mariaDallOrto/nimbus-telemetry/(list of files, drawings)

Other design files:
pcb/kmetria.PcbDoc
pcb/kmetria.PcbLib
pcb/kmetria.PrjPcb
pcb/kmetria.SchDoc
pcb/kmetria.SchLib
