mariaDallOrto/nimbus-telemetry/public/examples/test_paje.csv

Timestamp | PacketID | RSSI_dBm | Corrente_A | Comando_Pct | TensaoTotal_V | Celulas_N | C1 | C2 | C3 | C4 | C5 | C6 | Corrente_Med_A | Corrente_Min_A | LoopMs | PwmIdleMs
2026-06-01T22_53_46 | 27346 | -43 | 1.92 | 0 | 16.52 | 4 | 4.073 | 4.182 | 4.136 | 4.125 | 0.000 | 0.000 | -0.18 | -1.35 | 19 | 14
2026-06-01T22_53_46 | 27347 | -43 | 2.17 | 0 | 16.52 | 4 | 4.073 | 4.181 | 4.136 | 4.124 | 0.000 | 0.001 | -0.19 | -1.35 | 19 | 4
2026-06-01T22_53_46 | 27348 | -43 | 2.04 | 0 | 16.52 | 4 | 4.073 | 4.181 | 4.137 | 4.125 | 0.000 | 0.000 | -0.19 | -1.22 | 19 | 14
2026-06-01T22_53_46 | 27349 | -42 | 1.29 | 0 | 16.52 | 4 | 4.073 | 4.182 | 4.136 | 4.124 | 0.000 | 0.000 | -0.26 | -2.48 | 19 | 3
2026-06-01T22_53_46 | 27350 | -42 | 1.04 | 0 | 16.51 | 4 | 4.073 | 4.181 | 4.136 | 4.124 | 0.000 | 0.000 | -0.22 | -1.35 | 19 | 13
2026-06-01T22_53_46 | 27351 | -42 | 0.66 | 0 | 16.52 | 4 | 4.073 | 4.181 | 4.137 | 4.124 | 0.000 | 0.000 | -0.23 | -1.60 | 19 | 3
2026-06-01T22_53_46 | 27352 | -42 | 0.91 | 0 | 16.52 | 4 | 4.073 | 4.182 | 4.136 | 4.124 | 0.000 | 0.000 | -0.17 | -1.22 | 19 | 13
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
