mariaDallOrto/nimbus-telemetry/(commit log)

2025-10-28 teste dos sensores
2025-10-31 Update README with ESP32 pinout details
    Added pinout information for the ESP32 module.
2025-12-11 Add ESP32 telemetry dashboard HTML file
2025-12-11 Add current divider note for current sensor
    Added information about using a current divider for the current sensor.
2025-12-18 Add HSTS016L-A current sensor and battery monitor code
    This file implements the reading of the HSTS016L-A current sensor with an ESP32, including battery monitoring using ADS1115 and PWM signal processing from the R84 receiver.
2025-12-18 Add HSTS016L-A sensor reading and logging
    Implement sensor reading and data logging for HSTS016L-A current sensor with ESP32, including battery monitoring and SD card storage.
2025-12-19 Add ESP32 telemetry code for sensor monitoring
2025-12-29 Change chart data from voltage to current
    Updated the chart to plot current instead of voltage and adjusted related configurations.
2025-12-29 Revise README for ESP32 telemetry project
    Updated README to provide detailed project information, features, hardware requirements, connection diagrams, installation instructions, and usage guidelines for the ESP32 RC telemetry and data logger system.
2025-12-29 pcb files
    [kmetria.PcbDoc, kmetria.PcbLib, kmetria.PrjPcb, kmetria.SchDoc, kmetria.SchLib]
2026-06-02 chore(web): remove legacy single-file dashboard prototype
2026-06-02 fix(firmware): auto-remount SD on failure and lower SPI clock to 10MHz
    [esp-wifi.ino]
2026-06-02 feat(telemetry): add gearbox reduction to RPM and share motor params
2026-06-02 fix(charts): keep the legend clear of the zoom and fullscreen buttons
2026-06-02 feat(analysis): add selectable example CSV logs with descriptions
    [pico.csv, pico_balta_luta.csv, pico_balta_luta2.csv, test_paje.csv]
2026-06-02 chore(pcb): move kmetria board files into pcb/
    [kmetria.PcbDoc, kmetria.PcbLib, kmetria.PrjPcb, kmetria.SchDoc, kmetria.SchLib]
2026-10-24 feat(analysis): shareable example URLs, back button, named logs and fixed current sign
2026-10-24 feat(analysis): add clamp readings and default to mean current on a shared scale
2026-10-26 feat(energia): weapon energy and battery budget page (#1)
    New /energia route for the HAI beetleweight weapon: how much average current
    the weapon can pull in a 3-minute fight on the 4S 930 mAh pack, energy and
    current per stick %, a fight-plan budget, a preset-driven test explorer over
    the 2026-10-24 logs, and the step-by-step math behind every number. Energy
    comes from the spreadsheet RPM model.
2026-10-31 feat(analysis): add T-Motor example logs from 2026-10-31
2026-10-31 feat(firmware): send mean current as current, add peak field and persist zero offset
2026-10-31 feat(telemetry): parse and show peak current alongside mean current
2026-10-31 chore(analysis): remove T-Motor wifi example logs
2026-10-31 feat(firmware): add zero calibration command and report offset in status
2026-10-31 feat(telemetry): add zero calibration control and record serial logs only
